adityag6994/Heart-Rate-monitoring-system/README.md

# Heart-Rate-monitoring-system
Heart Rate monitoring system using Photoplethysmography (PPG)
